MattiaCazzolla/Sensors-project/README.md

# Arduino Thermostat with NTC Thermistor
Project from "Technologies for Sensors and Clinical Instrumentation" course. \
The aim of the project was to develop a thermostat relying on Arduino hardware and a uncalibrated NTC thermistor.\
We implemented the thermostat as a simplified neonatal incubator.
## Prototype
<p align="center">
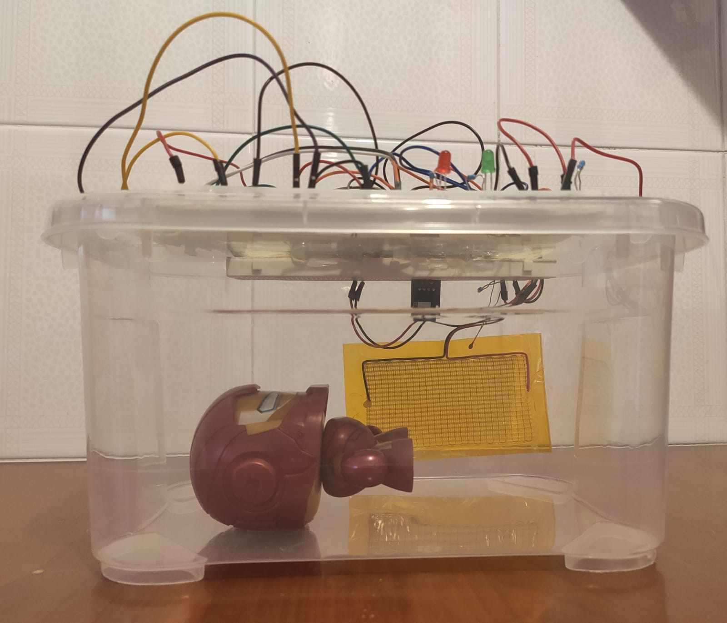
[picture p1: media/prototype photos/photo3.jpeg]
 
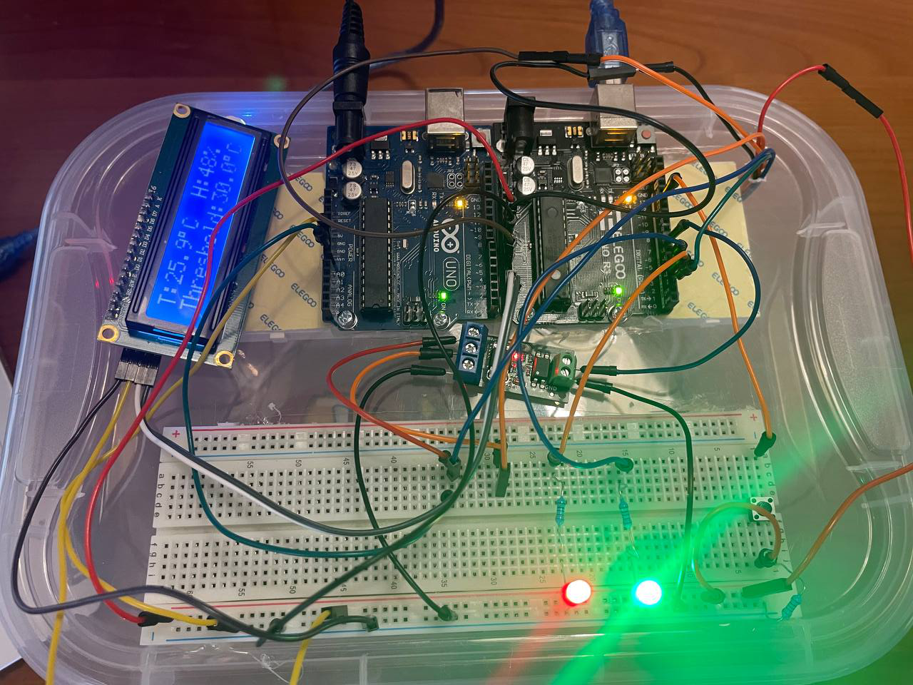
[picture p2: media/prototype photos/photo2.jpg]
 
</p>

## Repository structure
### Src
The **src** folder cointains:
- <code>interface.pde</code> ⟶ processing (java) code used for the GUI
- <code>firmware.ino</code> ⟶ arduino (C) code used as the firmware
- <code>img</code> ⟶ folder with images used in the GUI
### Media
The **media** folder contains:
- circuit and breadbord schematics
- GUI screenshots
- power point presentation
- video of the demo
- report of the project
## Contributors
- Mattia CAZZOLLA
- Mimma CERRETO
- Emma LACAGNINA
- Giorgia MAIMONE
- Ilaria MONACO
