MattiaCazzolla/Sensors-project/media/interface screenshots/Home Page.PNG

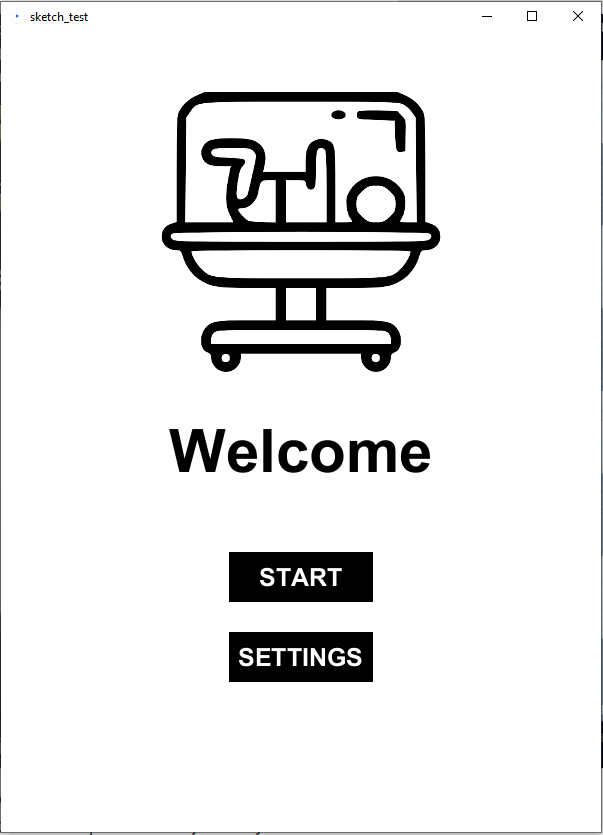
media/interface screenshots/Home Page.PNG
