MattiaCazzolla/Sensors-project/media/interface screenshots/Meter View.PNG

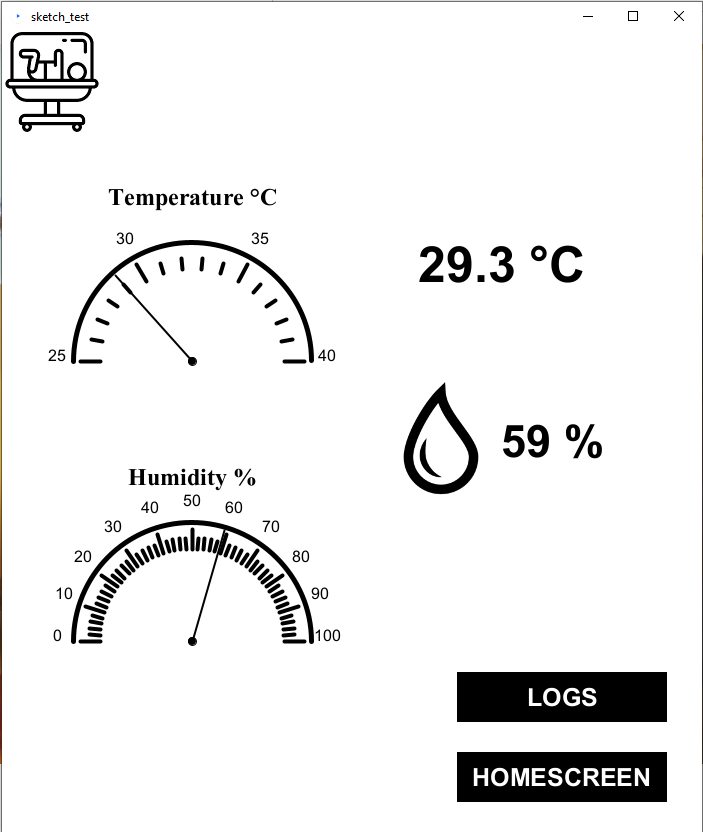
media/interface screenshots/Meter View.PNG
