MattiaCazzolla/Sensors-project/media/interface screenshots/Settings Page.PNG

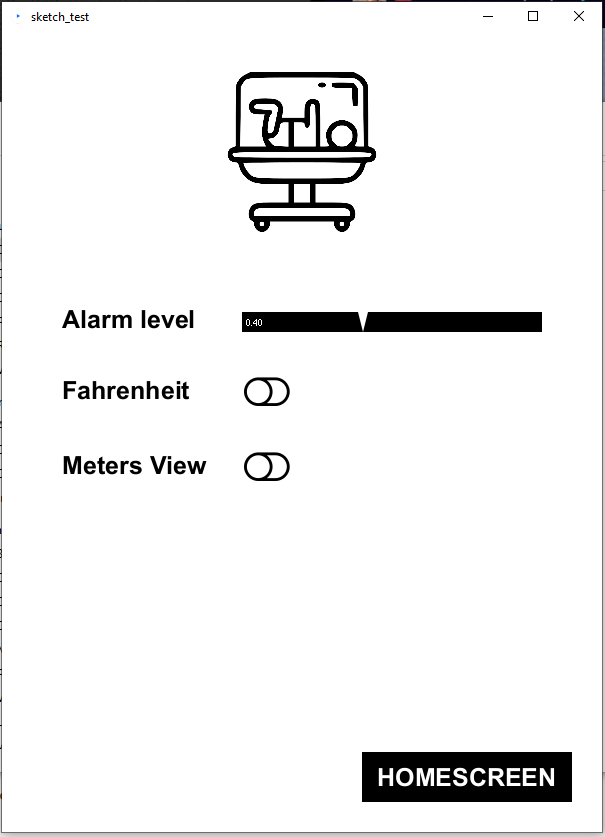
media/interface screenshots/Settings Page.PNG
