MattiaCazzolla/Sensors-project/media/interface screenshots/Thr error message.PNG

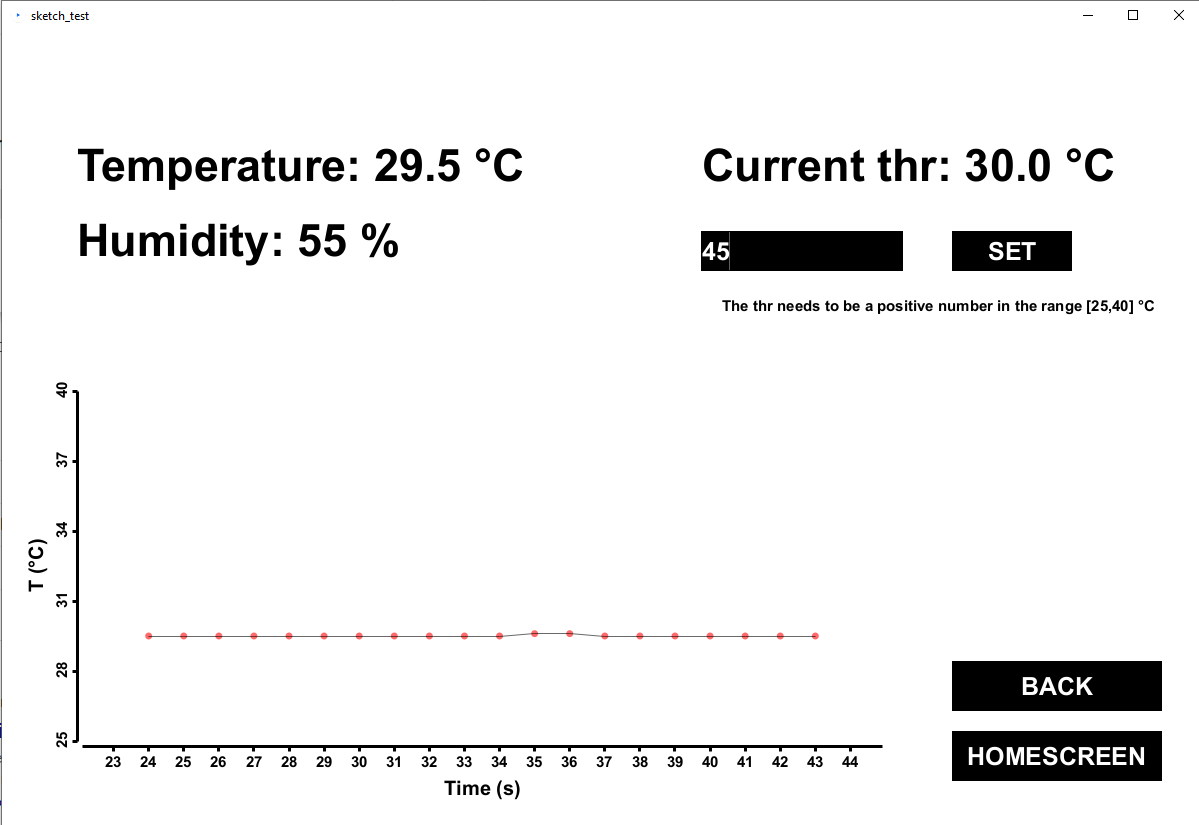
media/interface screenshots/Thr error message.PNG
