MattiaCazzolla/Sensors-project/media/interface screenshots/Trend Page.PNG

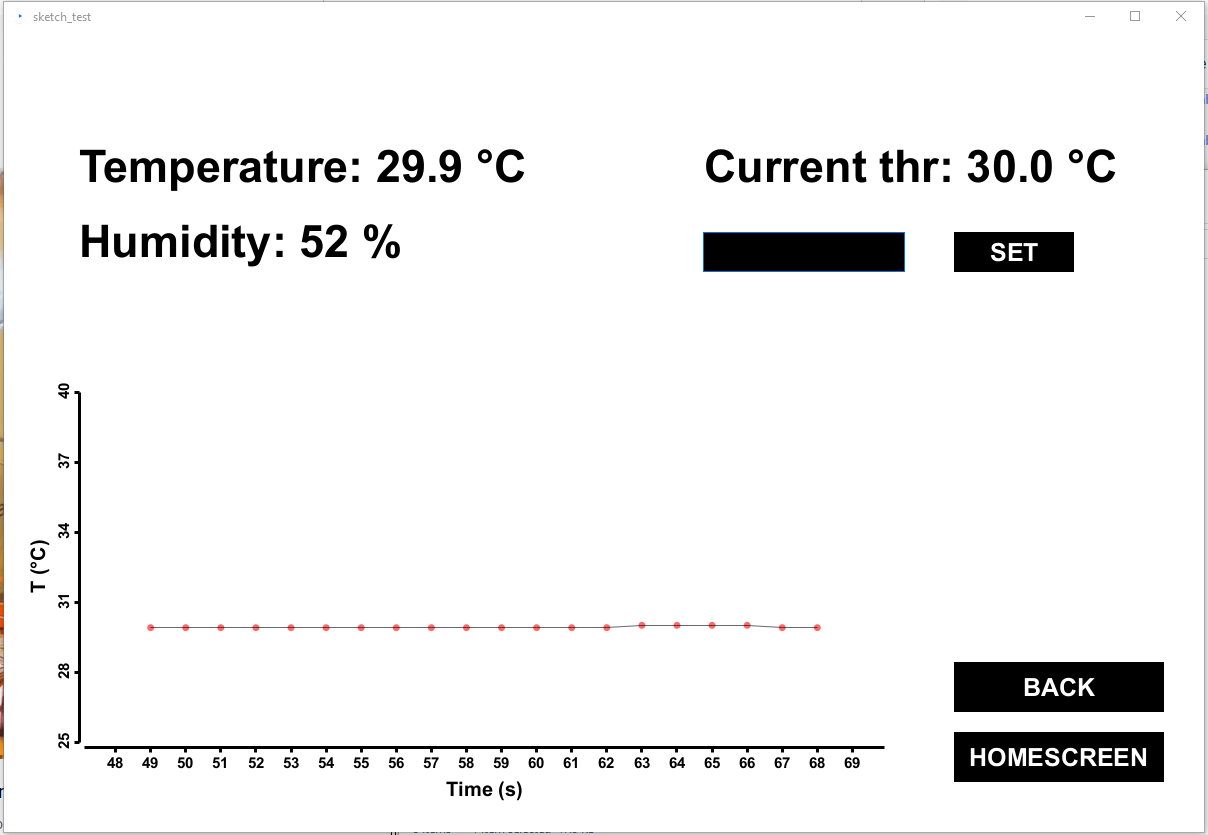
media/interface screenshots/Trend Page.PNG
