MattiaCazzolla/Sensors-project/media/prototype photos/photo1.jpeg

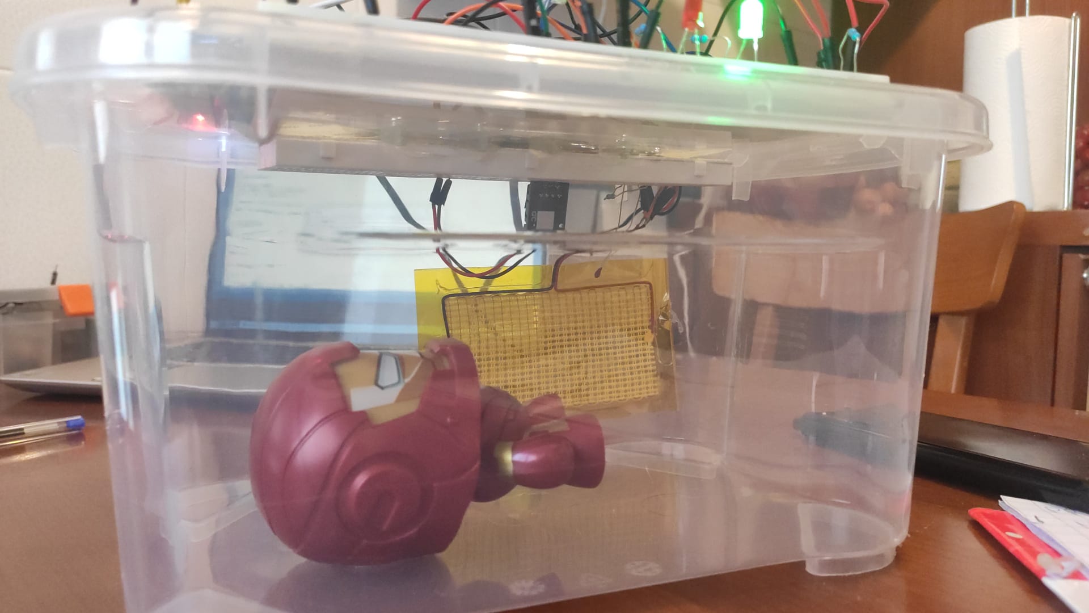
media/prototype photos/photo1.jpeg
