MattiaCazzolla/Sensors-project/src/img/drop2.png

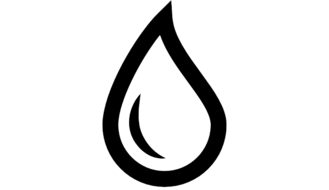
src/img/drop2.png
