MattiaCazzolla/Sensors-project/src/img/thermo.png

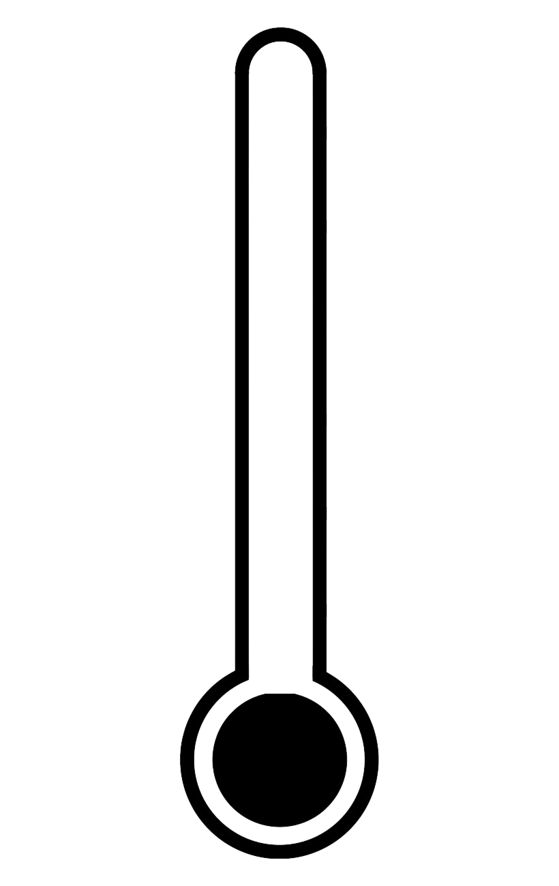
src/img/thermo.png
