MattiaCazzolla/Sensors-project/media/breadbord_schematic.pdf

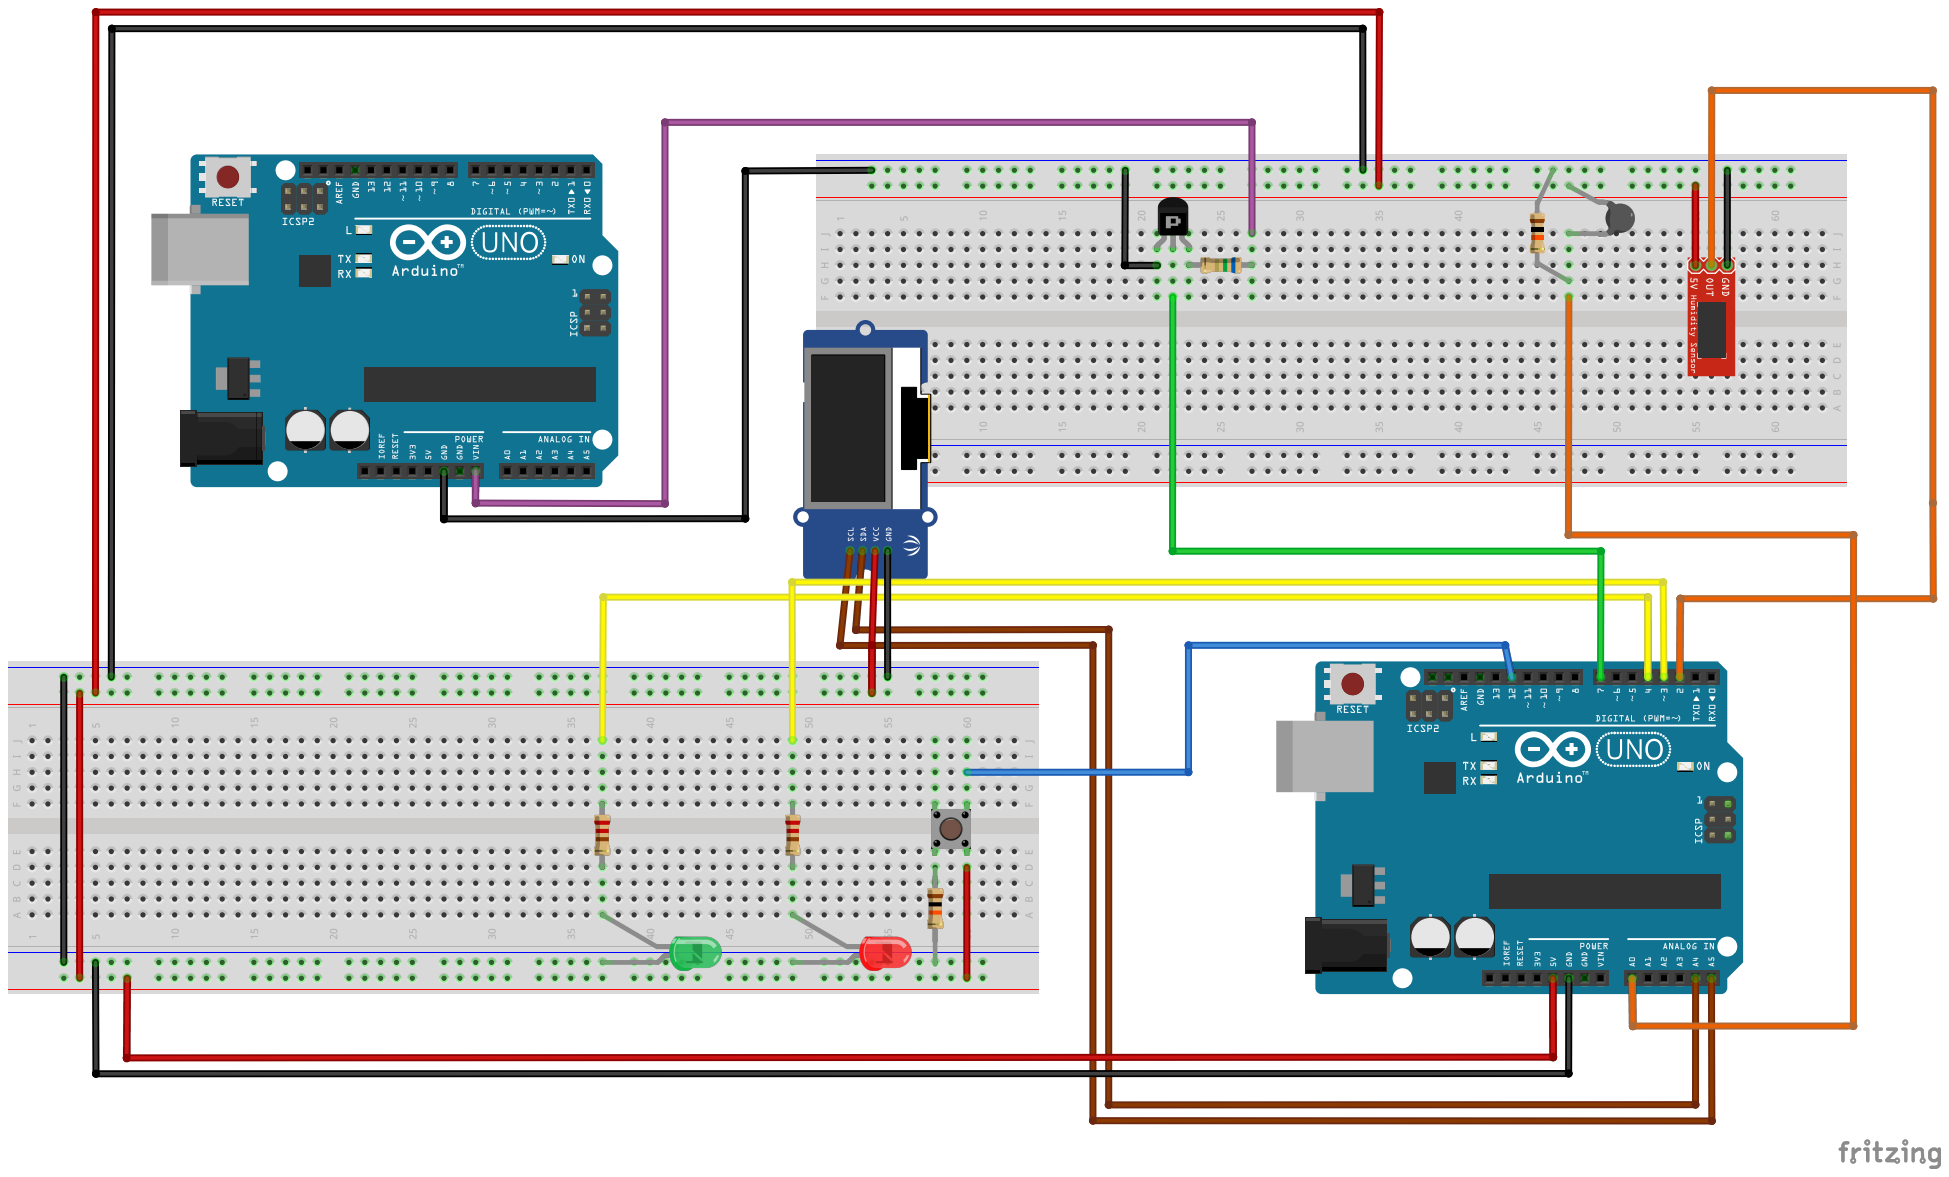
[picture p21: page 1]
