MattiaCazzolla/Sensors-project/media/circuit_schematic.pdf

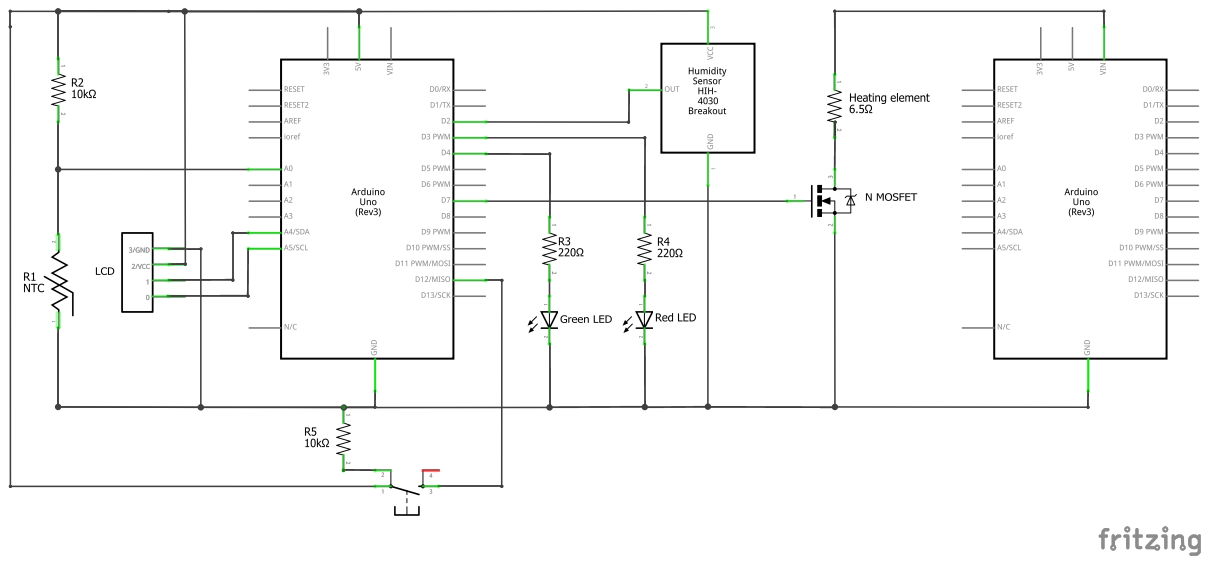
[picture p22: page 1]
